gnszhr/EE464-Hardware-Project/Simulation and Magnetic Design Report/Part6-Magnetic Design/WhatsApp Image 2022-05-13 at 23.06.59.jpeg

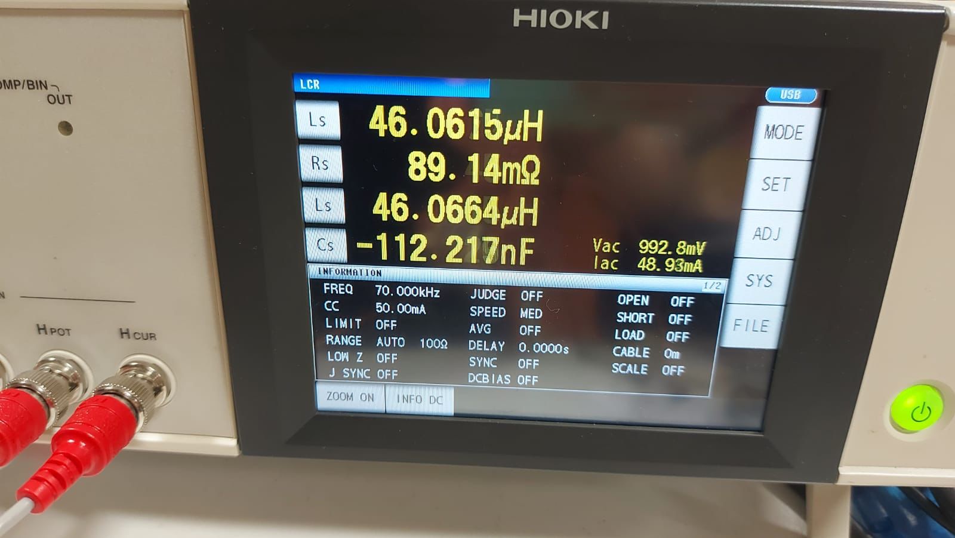
Simulation and Magnetic Design Report/Part6-Magnetic Design/WhatsApp Image 2022-05-13 at 23.06.59.jpeg
