gnszhr/EE464-Hardware-Project/README.md

# EE464-Hardware-Project
This repository is created for the term project of METU-EE464 course.
