gnszhr/EE464-Hardware-Project/Simulation and Magnetic Design Report/Part4-Analytical Calculations/Final Analytical Calculations_V2.docx

## Analytical Calculations

In this part, analytical calculations of the flyback converter are made for the nonideal case. According to the research, the duty cycle of the flyback converter should be lower than 0.5. Since the increase in duty cycle rises the energy storage duration, the duty cycle is proportional to core size. Therefore, considering the core size, and voltage stress on switch and diode, we have decided the turn ratio(Np/Ns) as 1 so that the duty cycle is changing between %29-%45.

The controller operates flyback in continuous current mode. All calculations are made assuming continuous current operation. We have taken boundary mode results as the limit values for continuous conduction. Therefore, continuous current mode formulas are utilized for boundary condition calculations.

- Duty cycle calculation,

VOR=V_(out) +V_F =V_(in) (D/(1-D))((N_s)/(N_p)) & V_(out) =15V & (N_s)/(N_p)=1 & V_F =0.78V

D=(VOR)/(VOR+V_(in))

When V_(in) =24V ,

D_(max) =0.39

When V_(in) =48V ,

D_(min) =0.247

The maximum required inductance can be calculated as follows [1],

L_m =(V_(in)^2 *η)/(K_L *P_o *f_s)*(V_(out)^2 *N_(ps)^2)/((V_(in) +V_(out) *N_(ps) )^2)

[1] Texas Instruments, “LM34XX how to design flyback converter with LM3481 boost ... - ti.com.” [Online]. Available: https://www.ti.com/lit/an/snva761a/snva761a.pdf. [Accessed: 09-May-2022].

Setting the magnetizing inductor current as:

ΔI_(Lm) =K_L * I_(Lm)

where,

• KL is the fraction chosen, we have chosen KL as 2 in order to set boundary operation.

- N_(ps) =1.33
- f_s =70kHz
- η=0.8 (nonideal case)

Then, minimum magnetizing inductance is determined when Vin=48V,

L_m _(min) =25.3µH

- Calculation of maximum voltages on diode and MOSFET,

V_(sw_(max)) = V_(in_(max)) + V_(out) * N_(ps) = 63V

V_(d_(max)) = V_(in_(max)) *N_(sp) + V_(out) =63V

Generally in applications, rated voltage of MOSFETs are chosen as 1.7 multiplication of maximum voltage while 1.5 multiple of maximum value in diodes,

V_(sw_(rated)) ≥107V

V_(d_(rated)) ≥94.5V

- Output capacitance calculation,

ΔV_o = ΔQ*C=(V_o * D_(max) * Ts)/(R * C) & ,(ΔV_o)/(V_o) ≤ 0.03

C ≥ 37 μF

# Magnetic Design

## a) Core selection

Since minimum magnetizing inductance is found as 25.3µH, magnetizing inductance is chosen as,

L_m =38µH

# According to the selected magnetizing inductance value, peak currents of primary and secondary are calculated,

# @ Vin=24V

# I_(in_(av)) =(45W)/(24V)=1.875A

# I_(pri_(av)) =(I_(in_(av)))/D=1.875/0.39=4.8A f_s =70kHz

# I_(Lm_(ripp)) =(V_(in) *D)/(f_s *L_m)=3.518A

# I_(pri_(peak)) =I_(pri_(av)) +(I_(Lm_(ripp)))/2=6.6A

# I_(sec_(peak)) =I_(pri_(peak)) *N_(ps) =6.6A

# @ Vin=48V

# I_(in_(av)) =(45W)/(48V)=0.9375A

# I_(pri_(av)) =(I_(in_(av)))/D=0.9375/0.247=3.795A

# I_(Lm_(ripp)) =(V_(in) *D)/(f_s *L_m)=4.45A

# I_(pri_(peak)) =I_(pri_(av)) +(I_(Lm_(ripp)))/2=6.02A

# I_(sec_(peak)) =I_(pri_(peak)) *N_(ps) =6.02A

After those calculations and some attempts to creating transformer, we have decided to use 0P43434EC. Magnetic properties and size of this core are suitable for our application.

Properties of 0P43434EC,

| Effective crosssectional area Ae (mm2) | Maximum Magnetic Flux density (T) | AL-value with the air gap (nH/N^2)
0P43434EC | 97.1 | 0.47 | 2933

Since AL value of this core is high for energy storage, we have decided to add air gap to the core. Air gap length is determined by choosing magnetic flux density.

# Choose Bac,max=0.2T which is below the saturation point of the cores we are investigating (0.47T). Also, maximum magnetic flux density is obtained when Vin=24V.

# B_(max) =(N_p I_p _(peak))/(RA_e)=(N_p *6.6)/(R*97.1*10^(-6))=0.2T @ V_(in) =24V

# (N_p)/R=N_p *A_L =2942*10^(-9)

# N_p =√((L_m)/(A_L)) & L_m =38µH & N_p =N_s =12

# Then,

# A_L =264nH/T^2

# Air gap calculation,

# R_(new) =R_(core) +R_(gap)

# 1/(A_(L,new))=1/(A_(L,core))+1/(A_(L,gap))

# 1/(264*10^(-9))-1/(2933*10^(-9))=R_(gap)

# R_(gap) =3.45*10^6 H^(-1)

# R_(gap) =(l_(gap))/(µ_0 A_e)

# l_(gap) =0.4mm

## b) Cable Selection

For the worst case, @24V

# I_(sec) _(rms) =4.7 A

# I_(pri) _(rms) =3.7A

# J_(rms) =4A/mm^2

# A_(pri) =0.925mm^2 & A_(sec) =1.175mm^2

# Choose,

# Primary-7*25 AWG-A_(cross) =7*0.162mm^2 =1.134mm^2

# Secondary-7*25 AWG-A_(cross) =7*0.162mm^2 =1.134mm^2

We have decided to use 7 parallel connected 25AWG instead of one AWG copper for primary, and 7 parallel connected 5AWG cable instead of one copper cable. Since cables with a larger cross-section have a smaller maximum frequency for 100% skin depth, we have decided to multiple cables that have enough maximum frequency for 100% skin depth instead of one cable. The maximum frequency for 100% skin depths is 85kHz for 26 AWG.This selection makes AC and DC resistances the same since we operate with 100% skin depth.

# Calculation of fill factor,

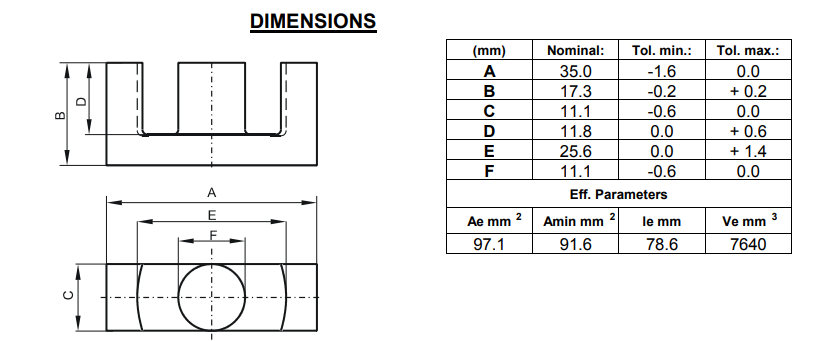
[picture p3: figure]

# A_(window) =(25.6-11.1)*11.8=85.55mm^2

# k_(cu) =(A_(copper) _(pri) +A_(copper) _(sec))/(A_(window))=(12*1.134+12*1.134)/85.55=0.32=%32

Core loss;

In order to obtain core loss, firstly, change in magnetic flux is calculates as follows,

L*ΔI_p =N*A_e *ΔB

ΔB=0.9T

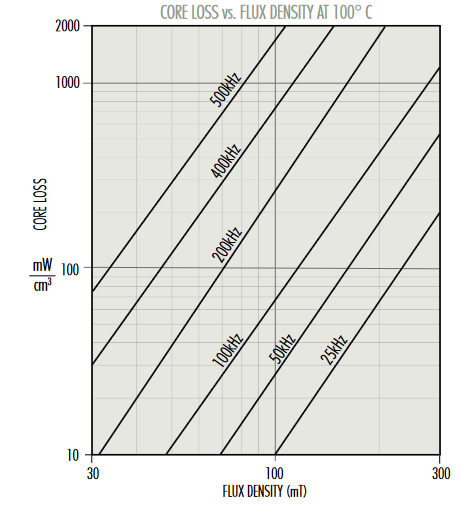
[picture p4: figure]

As seen from the graph, @70kHz and ΔB=0.9T , core loss density is approximetely equal to 40mW/cm^3. Then,

P_(core) =(40mW)/(cm^3)*7.64cm^3 =0.3056W

Copper loss,

# For primary winding, length of copper cable,

# R =N_(pri) *l_e *R(per mm)

# Primary cable of 25 AWG has 106.17Ω per km,

# R(per mm)=106.17(µΩ)/(mm)

# R=N_(pri) *l_e *R(per mm)=12*78.6*106.17*10^(-6) =100mΩ

# Since we connect 7 cable in parallel,

# R_(pri) =R/7=14.3mΩ

# For secondary winding, resistance is the same with primary copper losses since we have used the same AWG with equal amount.

# Calculation of copper losses,

# Primary copper losses,

# P_(pri_(losses)) =I_(pri)^2 *R_(pri) =3.7^2 *14.3*10^(-3) =196mW

# Secondary copper losses,

# P_(pri_(losses)) =I_(sec)^2 *R_(sec) =4.7^2 *14.3*10^(-3) =315mW

# Total copper losses,

# P_(copper) =P_(pri_(losses)) +P_(pri_(losses)) =0.5W

# Total losses,

# P_(losses) =P_(copper) +P_(core) =0.8W
