gnszhr/EE464-Hardware-Project/Simulation and Magnetic Design Report/Part6-Magnetic Design/Magnetic Design.docx

## Magnetic Design

### a) Core selection

For core selection, looking at area product of the core is a good start. Assume that the fill factor should be larger or equal to 0.3. Then, the limit of area product can be calculated as follows:

WaAc=(V_p I_p)/(2fk_(cu) B_(ac) J_(rms))

We decided Bac,max=0.12T which is below the saturation point of the cores we are investigating (0.3-0.47T). Also, maximum magnetic flux density is obtained when Vin=24V. Also, the current density is assumed as Jrms= 4A/mm²

k_(cu) ≥30%=0.3

WaAc=(V_p *I_p)/(2fk_(cu) B_(ac) J_(rms))=(45W)/(2*100kHz*0.3*0.12T*(3A)/(m^2)*10^6)≤0.15cm^4

Choosing WaAc of core=0.04cm4 which satisfies the above condition,

| Effective crosssectional area Ae (mm2) | Maximum Magnetic Flux density (T) | AL-value with the air gap (nH/N^2)
B66307G0500X187 [2] | 20.12 | 0.49 | 110

[2] https://www.tdk-electronics.tdk.com/inf/80/db/fer/e_16_8_5.pdf

This core is chosen since it has low AL with gap and cross-section is small compared to the others. 110nH/T2 is required to obtain the assumed magnetic flux density. 110nH/T2 can be obtained by the addition of 0.24mm air gap. This will be proved after other calculations. Also, a minimum cross-section that satisfies area product expectations is selected to make the most compact design.

Saturation flux density of the core is checked, and saturation value of the core is 0.49T for N87 material. Therefore, the core would not saturate.

# Calculation of turn numbers,

# Firstly find the condition that satisfy the core is not saturated,

# Np = (V_(in) * D * T_s)/(A_e * B_(sat)) = 11.5, N_1 ≥11.5

# Find the turn number,

# A_L =110nH

# N_1 =√((L_m)/(A_L))= √((14.2*10^3)/110)=11.4=12

# N_2 =N_(sp) *N_1 =12*0.7=8

# As calculated, primary turn number is larger than saturation turn number.

# As it is seen from the calculations, number of turns in primary secondary windings are selected as 12 and 8 respectively.

# Calculation of peak currents,

# @ Vin=24V(BCM)

# I_(in_(av)) =(45W)/(24V)=1.875A

# I_(pri_(av)) =(I_(in_(av)))/D=1.875/0.47=3.975A

# I_(Lm_(ripp)) =(V_(in) *D)/(f_s *L_m)=7.95A

# I_(pri_(peak)) =I_(pri_(av)) +(I_(Lm_(ripp)))/2=7.95A

# I_(sec_(peak)) =I_(pri_(peak)) *N_(ps) =11.4A

# @ Vin=48V(DCM)

# I_(Lm_(ripp)) =(V_(in) *D)/(f_s *L_m)=7.95A

# Since it is in BCM, ripple current is equal to maximum current,

# I_(pri_(peak)) =7.95A

# I_(sec_(peak)) =I_(pri_(peak)) *N_(ps) =11.4A

# Also, it is important to be sure expected magnetic flux density is obtained,

# B=(NI)/(RA)=(12*1.875*110*10^(-9))/(20.1*10^(-6))=0.116T @ V_(in) =24V

## b) Cable Selection

# I_(sec) _(rms) = 3A

# I_(pri) _(rms) =45/24=1.875A(Max value)

# J_(rms) =4A/mm^2

# A_(pri) =0.47mm^2 & A_(sec) =0.75mm^2

# Choose,

# Primary-4*26 AWG-A_(cross) =4*0.128mm^2 =0.512mm^2

# Secondary-6*26 AWG-A_(cross) =6*0.128mm^2 =0.768mm^2

We have decided to use 4 parallel connected 26AWG instead of one AWG copper for primary, and 6 parallel connected 26AWG cable instead of one copper cable. Since cables with a larger cross-section have a smaller maximum frequency for 100% skin depth, we have decided to multiple cables that have enough maximum frequency for 100% skin depth instead of one cable. The maximum frequency for 100% skin depths is 107kHz for 26 AWG.This selection makes AC and DC resistances the same since we operate with 100% skin depth.

# Calculation of fill factor,

# A_(window) =(11.3-4.7)/2*5.7=18.8mm^2

# k_(cu) =(A_(copper) _(pri) +A_(copper) _(sec))/(2*A_(window))=(12*0.512+8*0.768)/37.6=0.327

# =32.7%
