gnszhr/EE464-Hardware-Project/Simulation and Magnetic Design Report/Part4-Analytical Calculations/Analytical Calculations.docx

## Analytical Calculations(for 100kHz)

In this part, analytical calculations of the flyback converter are made for the ideal case. According to the research, the duty cycle of the flyback converter should be lower than 0.5 to diminish output ripple, also we made sure of the proper operation of the switch. Therefore, we have decided the turn ratio(N1/N2) as 1.43 so that the duty cycle is changing between %23-%47.

The controller operates flyback in boundary and discontinuous conduction mode. All calculations are made assuming boundary mode operation. We have taken boundary mode results as the limit values for discontinuous conduction. Therefore, continuous current mode formulas are utilized for boundary condition calculations. When Vin=24V, it operates at boundary condition and when input voltage increases it passes to the discontinuous current mode,

- Duty cycle calculation,

V_(out) =V_(in) (D/(D-1))((N_2)/(N_1)) & V_(out) =15V & (N_2)/(N_1)=0.7

When V_(in) =24V ,

D_(max) =0.47

The maximum required inductance can be calculated as follows [1],

L_m =(V_(in)^2 *η)/(K_L *P_o *f_s)*(V_(out)^2 *N_(ps)^2)/((V_(in) +V_(out) *N_(ps) )^2)

[1] Texas Instruments, “LM34XX how to design flyback converter with LM3481 boost ... - ti.com.” [Online]. Available: https://www.ti.com/lit/an/snva761a/snva761a.pdf. [Accessed: 09-May-2022].

Setting the magnetizing inductor current as:

ΔI_(Lm) =K_L * I_(Lm)

where,

• KL is the fraction chosen, we have chosen KL as 2 in order to set boundary operation.

- N_(ps) =1.43
- f_s =100kHz
- η=1 (ideal case)

Then, maximum magnetizing inductance is determined when Vin=24V so that it operates discontinous mode when input voltage increases.

L_m _(max) =14.2µH

After determining Lm, we can calculate minimum duty cycle when it pass to the DCM,

D=(V_(out))/(V_(in))*√((2*L_m *f_s)/R) & R=5Ω & L_m =14.2µH

Minimum duty cycle is calculated when Vin=48V,

D_(min) =0.2355

- Calculation of maximum voltages on diode and MOSFET,

V_(sw_(max)) = V_(in_(max)) + V_(out) * N_(ps) = 69.42V

V_(d_(max)) = V_(in_(max)) *N_(sp) + V_(out) = 31.8V

Generally in applications, rated voltage of MOSFETs are chosen as 1.5 multiplication of maximum voltage while 1.2 multiple of maximum value in diodes,

V_(sw_(rated)) =104V

V_(d_(rated)) =38V

- Output capacitance calculation,

ΔV_o = ΔQ*C=(V_o * D_(max) * Ts)/(R * C) & ,(ΔV_o)/(V_o) ≤ 0.03

C ≥ 31.4 μF

Choose,
C= 35 μF

ΔV_o =0.4V

ΔV_(o_(ESR)) = I_(LM_(max)) * ((N_1)/(N_2))* rc<0.05 , rc < 4.37mΩ

# Magnetic Design

## a) Core selection

For core selection, looking at area product of the core is a good start. Assume that the fill factor should be larger or equal to 0.3. Then, the limit of area product can be calculated as follows.

# WaAc=(V_p *I_p)/(2fk_(cu) B_(ac) J_(rms))

# Choose Bac,max=0.12T which is below the saturation point of the cores we are investigating (0.3-0.47T). Also, maximum magnetic flux density is obtained when Vin=24V.

# Jrms= 4A/mm²

# k_(cu) ≥30%=0.3

# WaAc=(V_p *I_p)/(2fk_(cu) B_(ac) J_(rms))=(45W)/(2*100kHz*0.3*0.12T*(3A)/(m^2)*10^6)≤0.15cm^4

# Choose WaAc of core=0.04cm⁴ which satisfies the above condition,

| Effective crosssectional area Ae (mm2) | Maximum Magnetic Flux density (T) | AL-value with the air gap (nH/N^2)
B66307G0500X187 | 20.1 | 0.49 | 110

# https://www.tdk-electronics.tdk.com/inf/80/db/fer/e_16_8_5.pdf

This core is chosen since it has low AL with gapp and cross-section is small compared to the others. 110nH/T² is required to obtain the assumed magnetic flux density. 110nH/T² can be obtained by the addition of 0.24mm air gap. This will be proved after other calculations. Also, a minimum cross-section that satisfies area product expectations is selected to make the most compact design.

# Saturation flux density of the core is checked, and saturation value of the core is 0.49T for N87 material. Therefore, the core would not saturate.

# Calculation of turn numbers,

# Firstly find the condition that satisfy the core is not saturated,

# Np = (V_(in) * D * T_s)/(A_e * B_(sat)) = 11.5, N_1 ≥11.5

# Find the turn number,

# A_L =110nH

# N_1 =√((L_m)/(A_L))= √((14.2*10^3)/110)=11.4=12

# N_2 =N_(sp) *N_1 =12*0.7=8

# As calculated, primary turn number is larger than saturation turn number.

# As it is seen from the calculations, number of turns in primary secondary windings are selected as 12 and 8 respectively.

# Calculation of peak currents,

# @ Vin=24V(BCM)

# I_(in_(av)) =(45W)/(24V)=1.875A

# I_(pri_(av)) =(I_(in_(av)))/D=1.875/0.47=3.975A

# I_(Lm_(ripp)) =(V_(in) *D)/(f_s *L_m)=7.95A

# I_(pri_(peak)) =I_(pri_(av)) +(I_(Lm_(ripp)))/2=7.95A

# I_(sec_(peak)) =I_(pri_(peak)) *N_(ps) =11.4A

# @ Vin=48V(DCM)

# I_(Lm_(ripp)) =(V_(in) *D)/(f_s *L_m)=7.95A

# Since it is in BCM, ripple current is equal to maximum current,

# I_(pri_(peak)) =7.95A

# I_(sec_(peak)) =I_(pri_(peak)) *N_(ps) =11.4A

# Also, it is important to be sure expected magnetic flux density is obtained,

# B=(NI)/(RA)=(12*1.875*110*10^(-9))/(20.1*10^(-6))=0.116T @ V_(in) =24V

## b) Cable Selection

# I_(sec) _(rms) = 3A

# I_(pri) _(rms) =45/24=1.875A(Max value)

# J_(rms) =4A/mm^2

# A_(pri) =0.47mm^2 & A_(sec) =0.75mm^2

# Choose,

# Primary-4*26 AWG-A_(cross) =4*0.128mm^2 =0.512mm^2

# Secondary-6*26 AWG-A_(cross) =6*0.128mm^2 =0.768mm^2

We have decided to use 4 parallel connected 26AWG instead of one AWG copper for primary, and 6 parallel connected 26AWG cable instead of one copper cable. Since cables with a larger cross-section have a smaller maximum frequency for 100% skin depth, we have decided to multiple cables that have enough maximum frequency for 100% skin depth instead of one cable. The maximum frequency for 100% skin depths is 107kHz for 26 AWG.This selection makes AC and DC resistances the same since we operate with 100% skin depth.

# Calculation of fill factor,

# A_(window) =(11.3-4.7)/2*5.7=18.8mm^2

# k_(cu) =(A_(copper) _(pri) +A_(copper) _(sec))/(2*A_(window))=(12*0.512+8*0.768)/37.6=0.327

# =32.7%

## Analytical Calculations(for70kHz)

In this part, analytical calculations of the flyback converter are made for the ideal case. According to the research, the duty cycle of the flyback converter should be lower than 0.5 to diminish output ripple, also we made sure of the proper operation of the switch. Therefore, we have decided the turn ratio(N1/N2) as 1.43 so that the duty cycle is changing between %23-%47.

The controller operates flyback in boundary and discontinuous conduction mode. All calculations are made assuming boundary mode operation. We have taken boundary mode results as the limit values for discontinuous conduction. Therefore, continuous current mode formulas are utilized for boundary condition calculations. When Vin=24V, it operates at boundary condition and when input voltage increases it passes to the discontinuous current mode,

- Duty cycle calculation,

V_(out) =V_(in) (D/(D-1))((N_2)/(N_1)) & V_(out) =15V & (N_2)/(N_1)=0.7

When V_(in) =24V ,

D_(max) =0.47

The maximum required inductance can be calculated as follows [1],

L_m =(V_(in)^2 *η)/(K_L *P_o *f_s)*(V_(out)^2 *N_(ps)^2)/((V_(in) +V_(out) *N_(ps) )^2)

[1] Texas Instruments, “LM34XX how to design flyback converter with LM3481 boost ... - ti.com.” [Online]. Available: https://www.ti.com/lit/an/snva761a/snva761a.pdf. [Accessed: 09-May-2022].

Setting the magnetizing inductor current as:

ΔI_(Lm) =K_L * I_(Lm)

where,

• KL is the fraction chosen, we have chosen KL as 2 in order to set boundary operation.

- N_(ps) =1.43
- f_s =70kHz
- η=1 (ideal case)

Then, maximum magnetizing inductance is determined when Vin=24V so that it operates discontinous mode when input voltage increases.

L_m _(max) =20.3µH

After determining Lm, we can calculate minimum duty cycle when it pass to the DCM,

D=(V_(out))/(V_(in))*√((2*L_m *f_s)/R) & R=5Ω & L_m =20.3µH

Minimum duty cycle is calculated when Vin=48V,

D_(min) =0.236

- Calculation of maximum voltages on diode and MOSFET,

V_(sw_(max)) = V_(in_(max)) + V_(out) * N_(ps) = 69.42V

V_(d_(max)) = V_(in_(max)) *N_(sp) + V_(out) = 31.8V

Generally in applications, rated voltage of MOSFETs are chosen as 1.5 multiplication of maximum voltage while 1.5 multiple of maximum value in diodes,

V_(sw_(rated)) ≥104V

V_(d_(rated)) ≥47.7V

- Output capacitance calculation,

ΔV_o = ΔQ*C=(V_o * D_(max) * Ts)/(R * C) & ,(ΔV_o)/(V_o) ≤ 0.03

C ≥ 45 μF

Choose,
C= 50 μF

ΔV_o =0.4V

ΔV_(o_(ESR)) = I_(LM_(max)) * ((N_1)/(N_2))* rc<0.05 , rc < 4.37mΩ

# Magnetic Design

## a) Core selection

For core selection, looking at area product of the core is a good start. Assume that the fill factor should be larger or equal to 0.3. Then, the limit of area product can be calculated as follows.

# WaAc=(V_p *I_p)/(2fk_(cu) B_(ac) J_(rms))

# Choose Bac,max=0.12T which is below the saturation point of the cores we are investigating (0.3-0.47T). Also, maximum magnetic flux density is obtained when Vin=24V.

# Jrms= 4A/mm²

# k_(cu) ≥15%=0.15

# WaAc=(V_p *I_p)/(2fk_(cu) B_(ac) J_(rms))=(45W)/(2*70kHz*0.15*0.12T*(3A)/(m^2)*10^6)≤0.44cm^4

# Choose WaAc of core=0.096cm⁴ which satisfies the above condition,

| Effective crosssectional area Ae (mm2) | Maximum Magnetic Flux density (T) | AL-value with the air gap (nH/N^2)
CF139EE2005S-AG-0.25MM | 33.5 | | 200

# https://cdn.ozdisan.com/ETicaret_Dosya/15564_9555141.PDF

This core is chosen since it has low AL with gapp and cross-section is small compared to the others. 200nH/T² is required to obtain the assumed magnetic flux density. 200nH/T² can be obtained by the addition of 0.25mm air gap. This will be proved after other calculations. Also, a minimum cross-section that satisfies area product expectations is selected to make the most compact design.

# Bsat=0.49???

# Calculation of turn numbers,

# Firstly find the condition that satisfy the core is not saturated,

# N_1 = (V_(in) * D * T_s)/(A_e * B_(sat)) = 9.82, N_1 ≥9.82

# Find the turn number,

# A_L =200nH

# N_1 =√((L_m)/(A_L))= √((20.3*10^3)/200)=10

# N_2 =N_(sp) *N_1 =10*0.7=7

# As calculated, primary turn number is larger than saturation turn number.

# As it is seen from the calculations, number of turns in primary secondary windings are selected as 10 and 7 respectively.

# Calculation of peak currents,

# @ Vin=24V(BCM)

# I_(in_(av)) =(45W)/(24V)=1.875A

# I_(pri_(av)) =(I_(in_(av)))/D=1.875/0.47=3.975A

# I_(Lm_(ripp)) =(V_(in) *D)/(f_s *L_m)=7.95A

# I_(pri_(peak)) =I_(pri_(av)) +(I_(Lm_(ripp)))/2=7.95A

# I_(sec_(peak)) =I_(pri_(peak)) *N_(ps) =11.4A

# @ Vin=48V(DCM)

# I_(Lm_(ripp)) =(V_(in) *D)/(f_s *L_m)=7.95A

# Since it is in BCM, ripple current is equal to maximum current,

# I_(pri_(peak)) =7.95A

# I_(sec_(peak)) =I_(pri_(peak)) *N_(ps) =11.4A

# Also, it is important to be sure expected magnetic flux density is obtained,

# B=(NI)/(RA)=(10*1.875*200*10^(-9))/(33.5*10^(-6))=0.11T @ V_(in) =24V

## b) Cable Selection

# I_(sec) _(rms) ≈ 3A

# I_(pri) _(rms) ≈45/24=1.875A(Max value)

# J_(rms) =4A/mm^2

# A_(pri) =0.47mm^2 & A_(sec) =0.75mm^2

# Choose,

# Primary-4*26 AWG-A_(cross) =4*0.128mm^2 =0.512mm^2

# Secondary-6*26 AWG-A_(cross) =6*0.128mm^2 =0.768mm^2

We have decided to use 4 parallel connected 26AWG instead of one AWG copper for primary, and 6 parallel connected 26AWG cable instead of one copper cable. Since cables with a larger cross-section have a smaller maximum frequency for 100% skin depth, we have decided to multiple cables that have enough maximum frequency for 100% skin depth instead of one cable. The maximum frequency for 100% skin depths is 107kHz for 26 AWG.This selection makes AC and DC resistances the same since we operate with 100% skin depth.

# Calculation of fill factor,

# A_(window) =(14.1-5.9)/2*7=28.7mm^2

# k_(cu) =(A_(copper) _(pri) +A_(copper) _(sec))/(2*A_(window))=(10*0.512+7*0.768)/67=0.183

# =18.3%
