gnszhr/EE464-Hardware-Project/Simulation and Magnetic Design Report/Part5-Computer Simulations/70 kHz/24 V/24V_Im_steadystate.tif

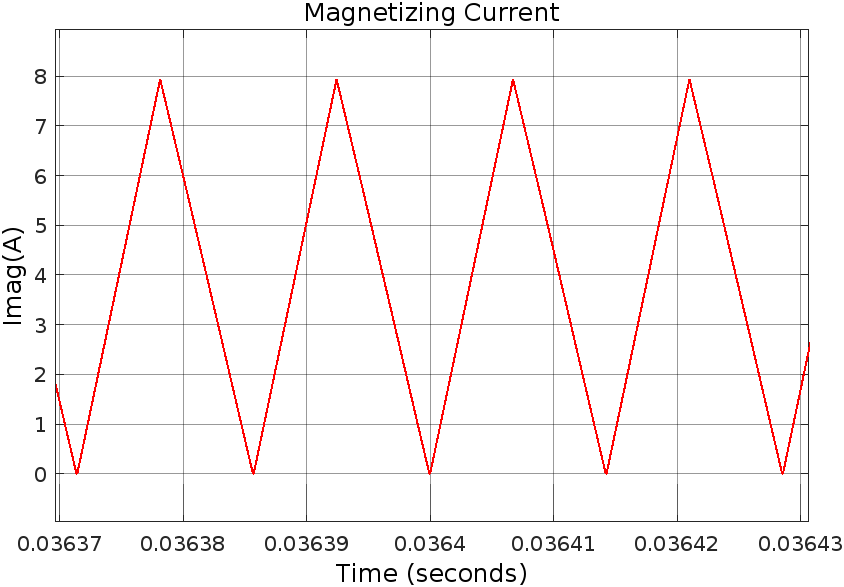
Simulation and Magnetic Design Report/Part5-Computer Simulations/70 kHz/24 V/24V_Im_steadystate.tif
