gnszhr/EE464-Hardware-Project/Simulation and Magnetic Design Report/Part5-Computer Simulations/70 kHz/24 V/24Vdiodecurrent_transient.tif

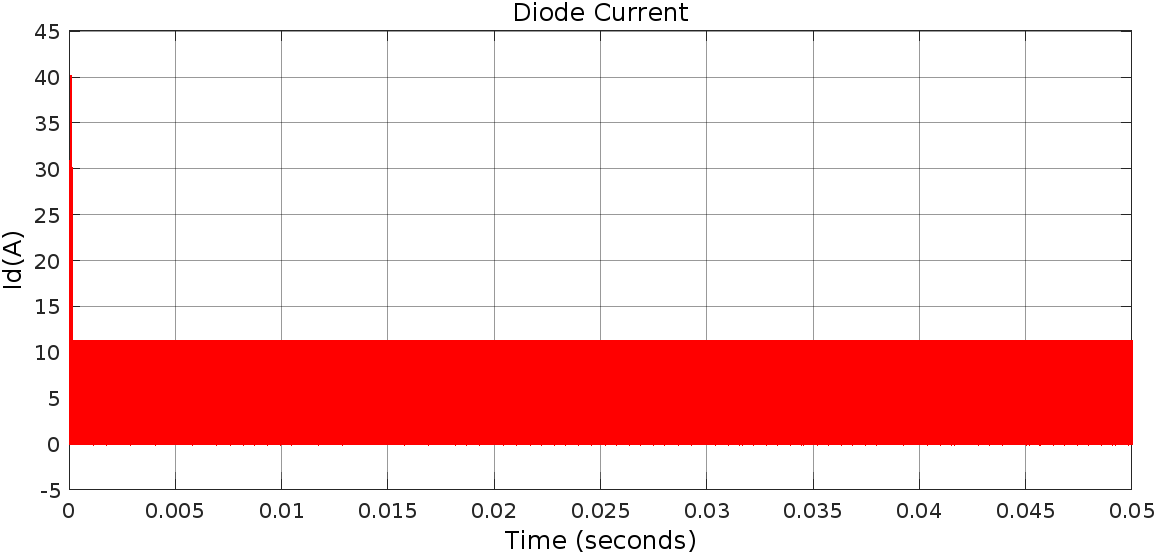
Simulation and Magnetic Design Report/Part5-Computer Simulations/70 kHz/24 V/24Vdiodecurrent_transient.tif
