gnszhr/EE464-Hardware-Project/Simulation and Magnetic Design Report/Part5-Computer Simulations/70 kHz/48 V/48V_Im_steadystate.tif

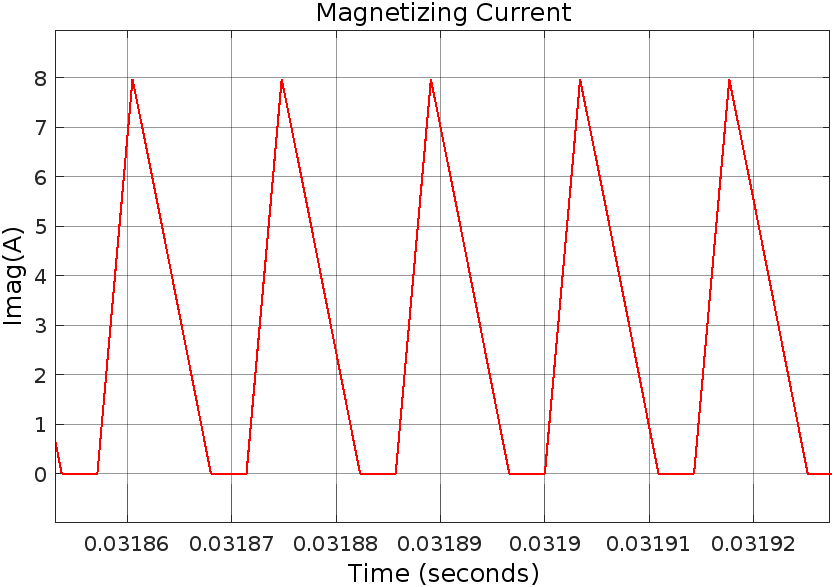
Simulation and Magnetic Design Report/Part5-Computer Simulations/70 kHz/48 V/48V_Im_steadystate.tif
