gnszhr/EE464-Hardware-Project/Simulation and Magnetic Design Report/Part5-Computer Simulations/LTSpice-LT1242/LTSpice Figures/24V/48out.png

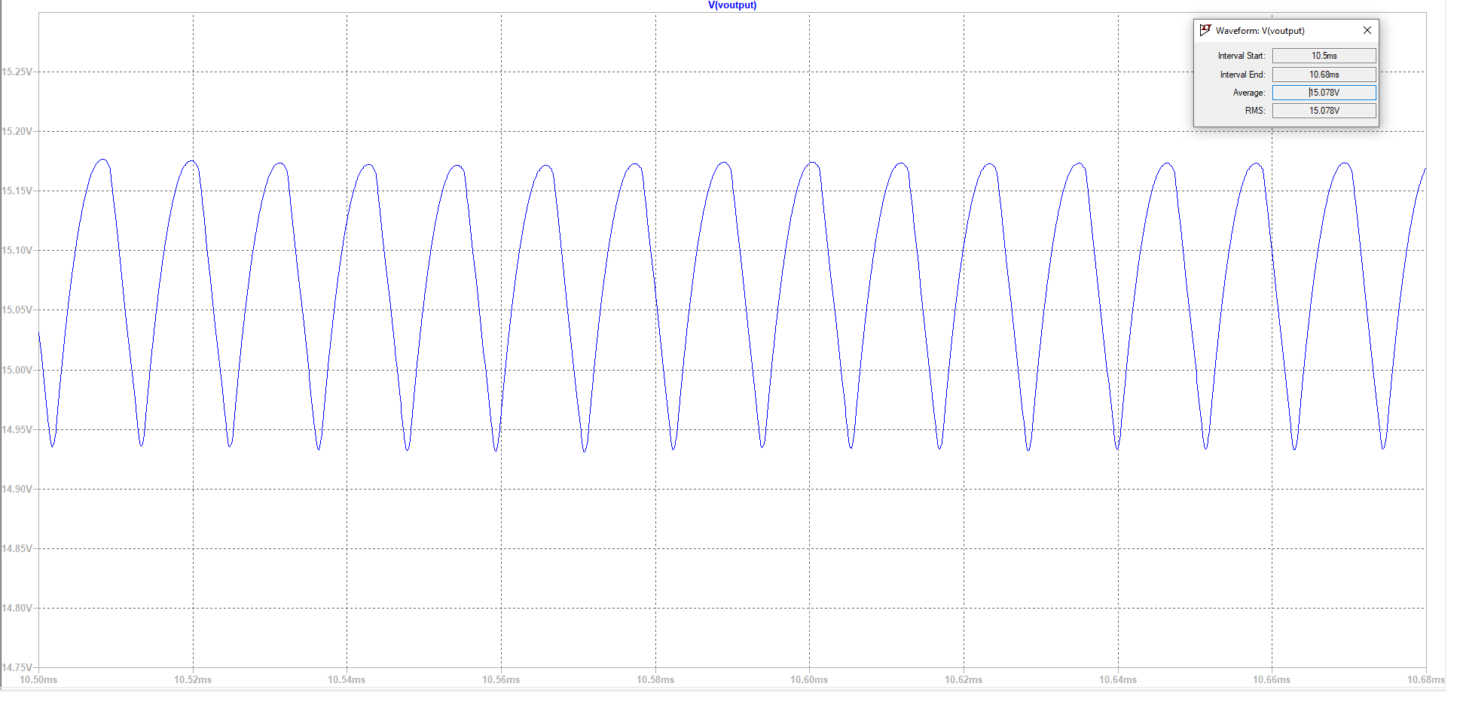
Simulation and Magnetic Design Report/Part5-Computer Simulations/LTSpice-LT1242/LTSpice Figures/24V/48out.png
