gnszhr/EE464-Hardware-Project/Simulation and Magnetic Design Report/Part1-Introduction/Order of Report.JPG

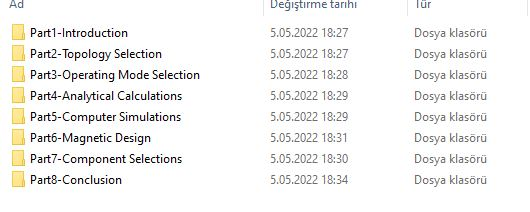
Simulation and Magnetic Design Report/Part1-Introduction/Order of Report.JPG
