gnszhr/EE464-Hardware-Project/Simulation and Magnetic Design Report/Part5-Computer Simulations/70 kHz_CCM_Operation/24 V/duty_for_24.PNG

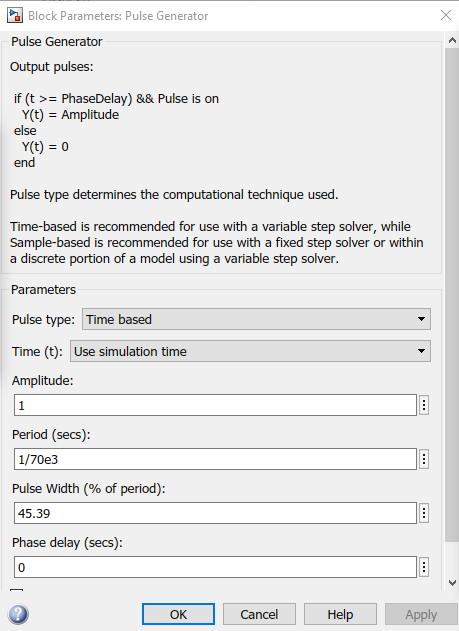
Simulation and Magnetic Design Report/Part5-Computer Simulations/70 kHz_CCM_Operation/24 V/duty_for_24.PNG
