gnszhr/EE464-Hardware-Project/Simulation and Magnetic Design Report/Part5-Computer Simulations/70 kHz_CCM_Operation/48 V/duty_for_48.PNG

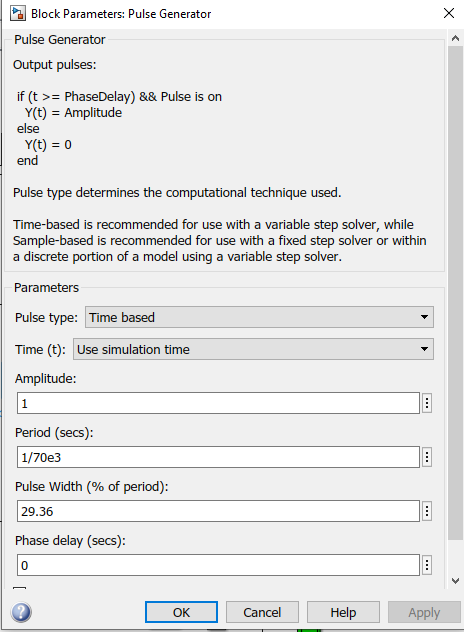
Simulation and Magnetic Design Report/Part5-Computer Simulations/70 kHz_CCM_Operation/48 V/duty_for_48.PNG
