gnszhr/EE464-Hardware-Project/Simulation and Magnetic Design Report/Part5-Computer Simulations/70 kHz_CCM_Operation/flyback_70khz.PNG

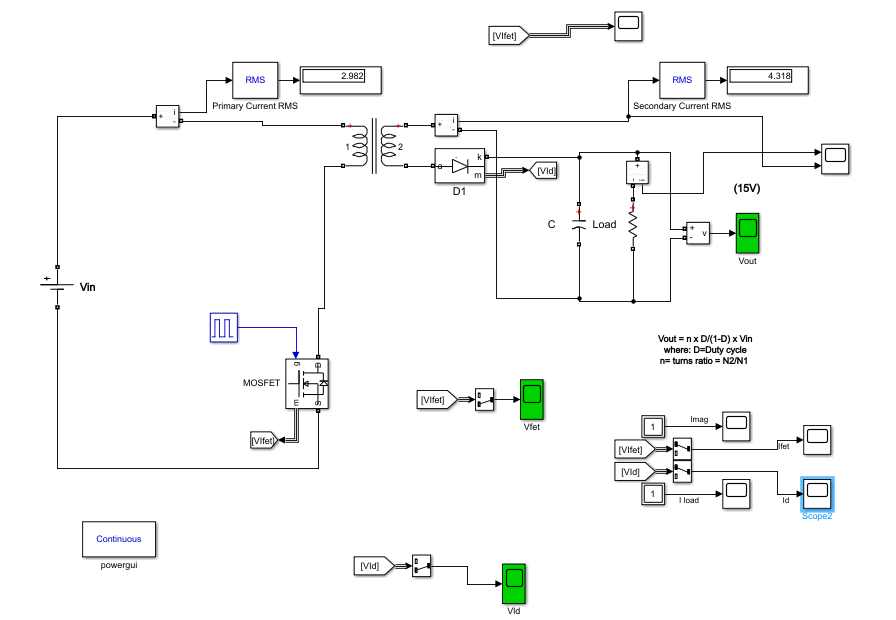
Simulation and Magnetic Design Report/Part5-Computer Simulations/70 kHz_CCM_Operation/flyback_70khz.PNG
