gnszhr/EE464-Hardware-Project/Simulation and Magnetic Design Report/Part5-Computer Simulations/70 kHz_CCM_Operation/transformer.PNG

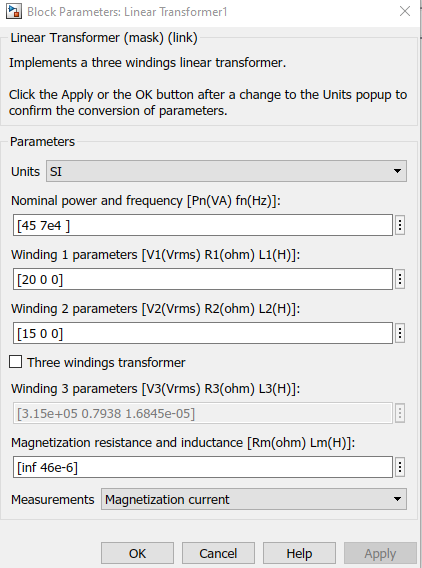
Simulation and Magnetic Design Report/Part5-Computer Simulations/70 kHz_CCM_Operation/transformer.PNG
