gnszhr/EE464-Hardware-Project/Simulation and Magnetic Design Report/Part5-Computer Simulations/LTSpice-LT1242/LT1242_simulation.asc

C4: cap; 1n
C5: cap; 22p
C6: cap; 470p; Rser=82p
C7: cap; 27µ; Rser=27u
C11: cap; 2.2µ; Rser=5m
Cct: cap; 2n
Coutput: cap; 50µ
Csense: cap; 470p
Csnubber: cap; 330n
Cvcc1: cap; 22µ
Cvcc2: cap; 100n
Cvref: cap; 1µ
D1: schottky; RB205T-40
D3: diode; RF05VAM2S
D4: diode
D6: diode
Dsnubber: diode
Lleakage: ind; 1.72µ
Lprimary: ind2; 46µ
Lsecondary: ind2; 25.875µ
Lthird: ind2; 25.875µ
M1: nmos; Si4848DY
Q1: npn; 2N2222
Q2: npn; 2N2222
R3: res; 10
R5: res; 10k
R10: res; 3.4k
R11: res; 7.15k
R13: res; 15.4k
R14: res; 205k
R17: res; 1.1k
R19: res; 3.4k
R22: res; 5k
Rbleeder: res; 1k
Rct: res; 8k
Rdiv1: res; 13.7k
Rdiv2: res; 2.74k
Rf: res; 500
Rmosfet: res; 10
Routput: res; 5
Rsense: res; 0.1
Rsnubber: res; 1.2k
Rstartup: res; 3k
U1: LT1242
U2: LT1009
U3: PC817A
Vinput: voltage; 24
Named nets: 0, Vinput, Voutput, Vdiode1, Vdiode2
.tran 0.02
K1 Lprimary Lsecondary Lthird 1
