gnszhr/EE464-Hardware-Project/(commit log)

2022-05-05 Useful Gate Driver documents
2022-05-05 The possible order for the report
    To show each headline file in GitHub Desktop, same order screenshot was attached as a reminder.
2022-05-05 Introduction was attached
    Introduction is added.
2022-05-05 Calculations, magnetic design and core selection
2022-05-10 magnetic design part added
2022-05-12 70 kHz simulation results were added.
    All graphs and updated template were attached. Transformer, capacitance, switch parameters were updated as well.
2022-05-13 Magnetıng Inductance of the transformer
2022-05-15 Create RCD Snubber Design for Flyback.docx
    Theoratical analysis is added for RCD Snubber circuit.
